shivaprsd/msc-lab-project/project_report/fig1.png

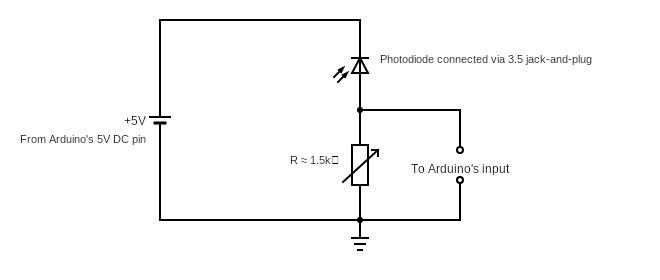
project_report/fig1.png
